imsandli/esp32-access-bridge/hardware/docs/images/pcb-bottom.png

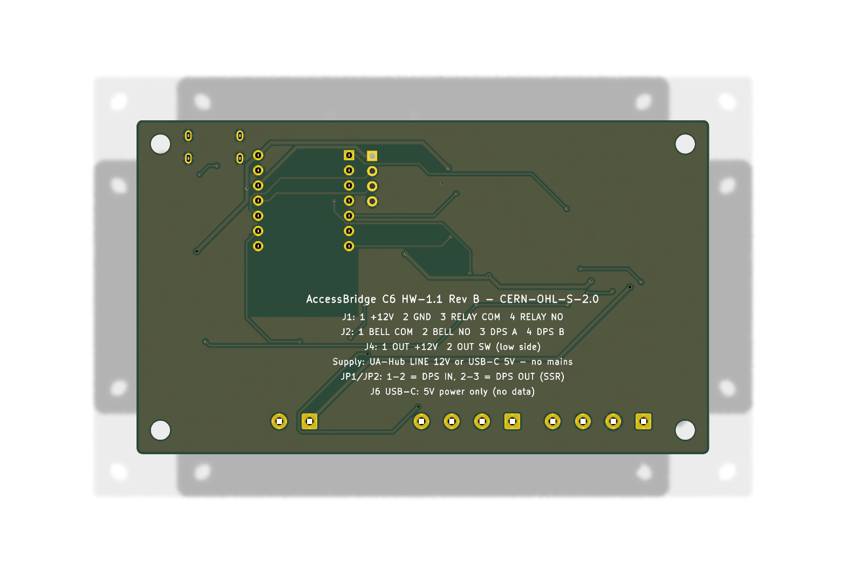
hardware/docs/images/pcb-bottom.png
