imsandli/esp32-access-bridge/hardware/docs/images/pcb-top.png

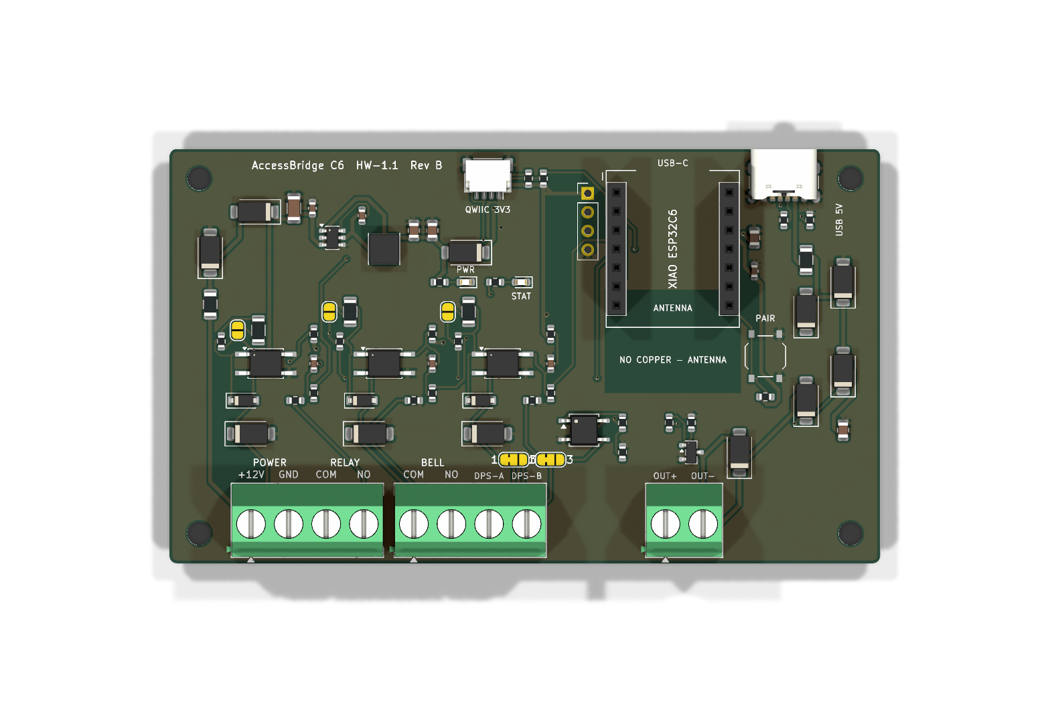
hardware/docs/images/pcb-top.png
