imsandli/esp32-access-bridge/hardware/enclosure/drawings/enclosure-base-din-underside.png

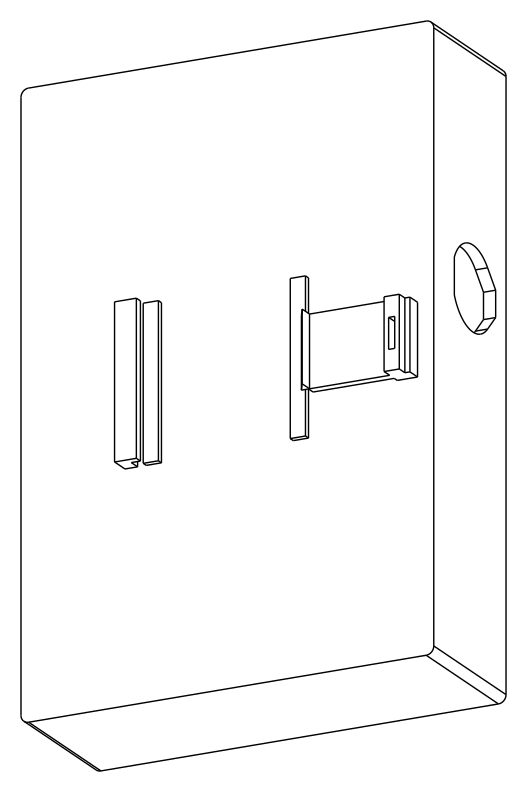
hardware/enclosure/drawings/enclosure-base-din-underside.png
