imsandli/esp32-access-bridge/hardware/enclosure/drawings/enclosure-base-top.png

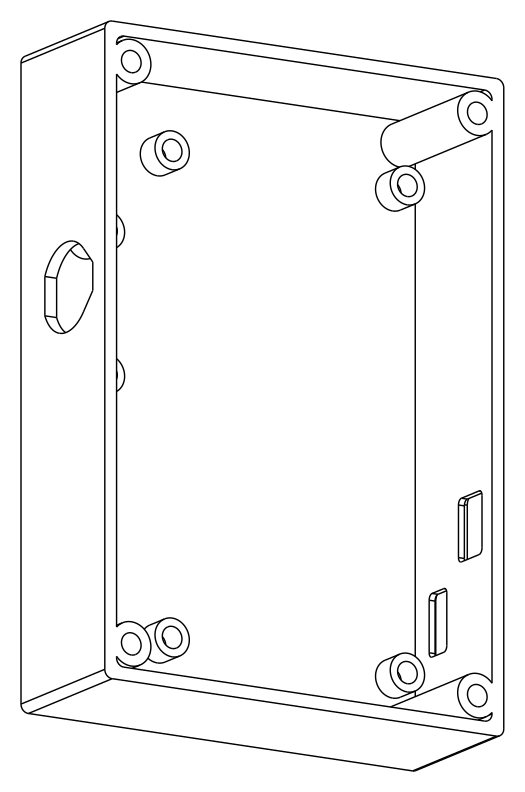
hardware/enclosure/drawings/enclosure-base-top.png
