imsandli/esp32-access-bridge/hardware/enclosure/drawings/enclosure-base-usb-side.png

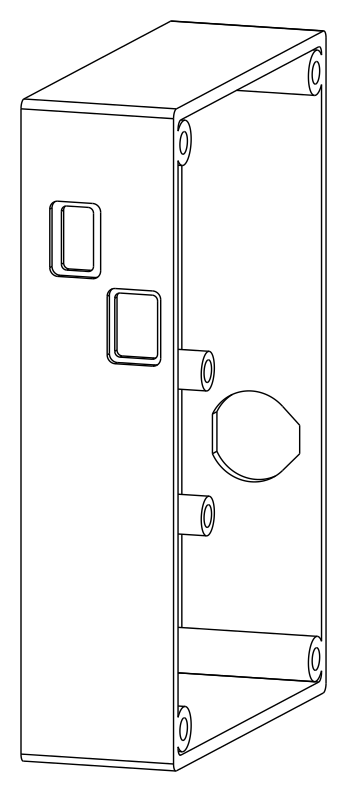
hardware/enclosure/drawings/enclosure-base-usb-side.png
