imsandli/esp32-access-bridge/hardware/enclosure/drawings/enclosure-base-wall-underside.png

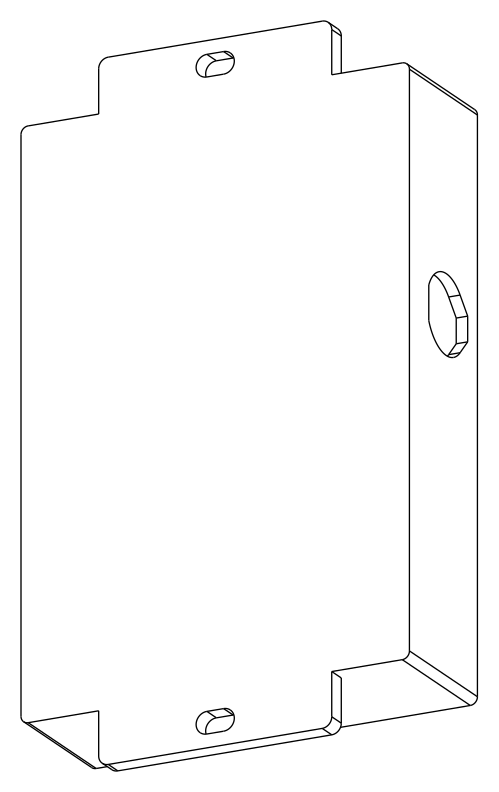
hardware/enclosure/drawings/enclosure-base-wall-underside.png
