imsandli/esp32-access-bridge/hardware/enclosure/drawings/enclosure-base-wall.png

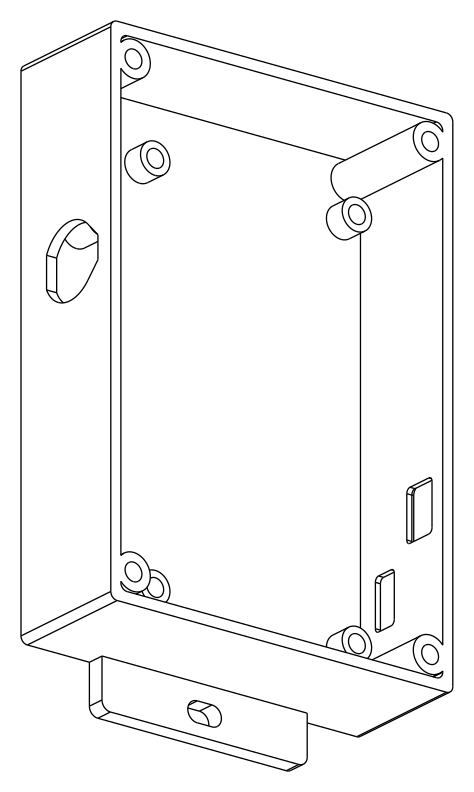
hardware/enclosure/drawings/enclosure-base-wall.png
