imsandli/esp32-access-bridge/hardware/enclosure/drawings/enclosure-lid.png

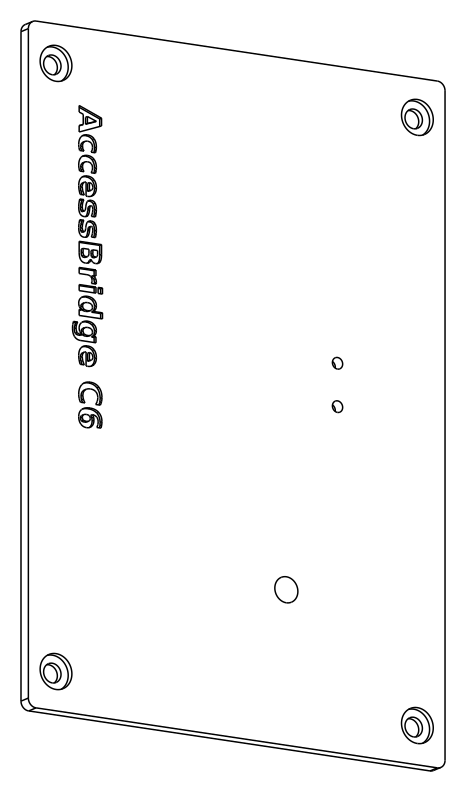
hardware/enclosure/drawings/enclosure-lid.png
