imsandli/esp32-access-bridge/hardware/manufacturing/bom/accessbridge-bom-full.csv

Designator | Value | Footprint | Manufacturer | MPN | LCSC | LCSC status | Qty | DNP
C1 | 10u/50V | Capacitor_SMD:C_1206_3216Metric | Samsung | CL31A106KBHNNNE | C13585 | secondary | 1
C2,C3,C7 | 100n | Capacitor_SMD:C_0603_1608Metric | YAGEO | CC0603KRX7R9BB104 | C14663 | confirmed | 3
C4,C5 | 22u/25V | Capacitor_SMD:C_0805_2012Metric | Samsung | CL21A226MAQNNNE | C45783 | secondary | 2
C6,C11 | 10u/25V | Capacitor_SMD:C_0805_2012Metric | Samsung | CL21A106KAYNNNE | C15850 | secondary | 2
C8,C9,C10 | 10n | Capacitor_SMD:C_0603_1608Metric | FH | 0603B103K500NT | C57112 | confirmed | 3
D1 | SMAJ15A | Diode_SMD:D_SMA | Littelfuse | SMAJ15A | C148216 | confirmed | 1
D2,D3,D12,D13,D15,D16 | SS14 | Diode_SMD:D_SMA | MDD | SS14 | C2480 | confirmed | 6
D4 | yellow-green | LED_SMD:LED_0603_1608Metric | Hubei KENTO | KT-0603YG | C2289 | confirmed | 1
D5 | red | LED_SMD:LED_0603_1608Metric | Hubei KENTO | KT-0603R | C2286 | secondary | 1
D6,D7,D8 | 1N4148W | Diode_SMD:D_SOD-123 | ST(Semtech) | 1N4148W | C81598 | confirmed | 3
D9,D10,D11 | SMAJ15CA | Diode_SMD:D_SMA | MDD | SMAJ15CA | C110044 | confirmed | 3
D14 | SMAJ5.0A | Diode_SMD:D_SMA | Littelfuse | SMAJ5.0A | C83329 | confirmed | 1
F1 | 200mA/30V | Fuse:Fuse_1206_3216Metric | BHFUSE | BSMD1206-020-30V | C883118 | confirmed | 1
F2 | 500mA/30V | Fuse:Fuse_1206_3216Metric | BHFUSE | BSMD1206-050-30V | C883126 | confirmed | 1
J1 | PWR+RELAY | TerminalBlock_Phoenix:TerminalBlock_Phoenix_MKDS-1,5-4-5.08_1x04_P5.08mm_Horizontal | Phoenix Contact | MKDS 1,5/ 4-5,08 (1715747) or 5.08 mm equivalent |  | manual | 1
J2 | BELL+DPS | TerminalBlock_Phoenix:TerminalBlock_Phoenix_MKDS-1,5-4-5.08_1x04_P5.08mm_Horizontal | Phoenix Contact | MKDS 1,5/ 4-5,08 (1715747) or 5.08 mm equivalent |  | manual | 1
J3 | Qwiic | Connector_JST:JST_SH_SM04B-SRSS-TB_1x04-1MP_P1.00mm_Horizontal | JST | SM04B-SRSS-TB(LF)(SN) | C160404 | confirmed | 1
J4 | OUT | TerminalBlock_Phoenix:TerminalBlock_Phoenix_MKDS-1,5-2-5.08_1x02_P5.08mm_Horizontal | Phoenix Contact | MKDS 1,5/ 2-5,08 (1715721) or 5.08 mm equivalent |  | manual | 1
J5 | EXP | Connector_PinHeader_2.54mm:PinHeader_1x04_P2.54mm_Vertical | generic | 2.54 mm 1x4 pin header |  | manual | 1 | DNP
J6 | USB-C 5V | Connector_USB:USB_C_Receptacle_GCT_USB4125-xx-x_6P_TopMnt_Horizontal | GCT | USB4125-GF-A | C3151650 | confirmed | 1
L1 | 4.7u | Inductor_SMD:L_Changjiang_FNR4030S | Sunlord | SWPA4030S4R7MT | C57269 | confirmed | 1
Q1 | AO3400A | Package_TO_SOT_SMD:SOT-23 | AOS | AO3400A | C20917 | confirmed | 1
R1,R2,R11,R13,R15,R17,R19,R21 | 1k | Resistor_SMD:R_0603_1608Metric | UNI-ROYAL | 0603WAF1001T5E | C21190 | confirmed | 8
R3,R7,R9,R12,R16,R20 | 10k | Resistor_SMD:R_0603_1608Metric | UNI-ROYAL | 0603WAF1002T5E | C25804 | confirmed | 6
R4,R5 | 4.7k | Resistor_SMD:R_0603_1608Metric | UNI-ROYAL | 0603WAF4701T5E | C23162 | confirmed | 2
R6 | 100 | Resistor_SMD:R_0603_1608Metric | UNI-ROYAL | 0603WAF1000T5E | C22775 | secondary | 1
R8 | 470 | Resistor_SMD:R_0603_1608Metric | UNI-ROYAL | 0603WAF4700T5E | C23179 | confirmed | 1
R10,R14,R18 | 2.2k | Resistor_SMD:R_0603_1608Metric | UNI-ROYAL | 0603WAF2201T5E | C4190 | secondary | 3
R22,R23 | 5.1k | Resistor_SMD:R_0603_1608Metric | UNI-ROYAL | 0603WAF5101T5E | C23186 | confirmed | 2
R24,R25,R26 | 1k | Resistor_SMD:R_1206_3216Metric | UNI-ROYAL | 1206W4F1001T5E | C4410 | confirmed | 3
SW1 | PAIR | Button_Switch_SMD:SW_Push_1P1T_XKB_TS-1187A | XKB | TS-1187A-B-A-B | C318884 | confirmed | 1
U1 | AP63205WU-7 | Package_TO_SOT_SMD:TSOT-23-6 | Diodes Inc. | AP63205WU-7 | C2071056 | confirmed | 1
U2 | XIAO_ESP32C6 | AccessBridge:XIAO_ESP32C6_Socketed | Seeed Studio | 113991254 (module) + 2x female header 1x7 2.54 mm |  | manual | 1
U3,U4,U5 | EL357C | Package_SO:SO-4_4.4x3.6mm_P2.54mm | UMW | EL357C | C725794 | confirmed | 3
U6 | CPC1014NTR | Package_SO:SOP-4_3.8x4.1mm_P2.54mm | Littelfuse/IXYS | CPC1014NTR | C2760365 | confirmed | 1
