imsandli/esp32-access-bridge/hardware/enclosure/models/accessbridge-enclosure-base-wall.step

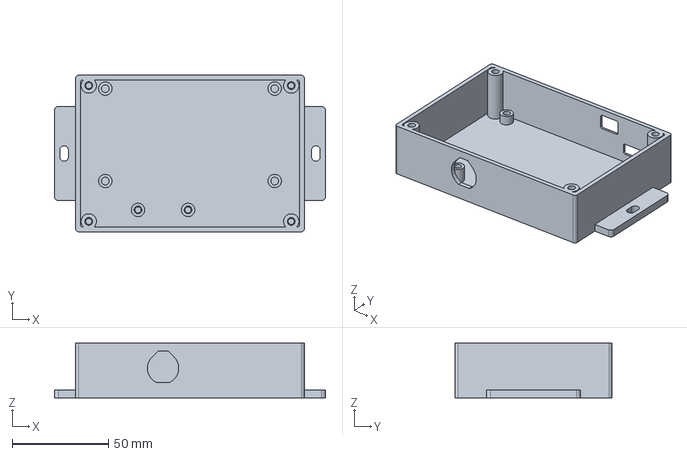
[picture p11: CAD file, 2026-10-18]
hardware/enclosure/models/accessbridge-enclosure-base-wall.step
140.8 x 81.4 x 28.5 mm
