imsandli/esp32-access-bridge/hardware/enclosure/models/pcb/accessbridge-c6.step

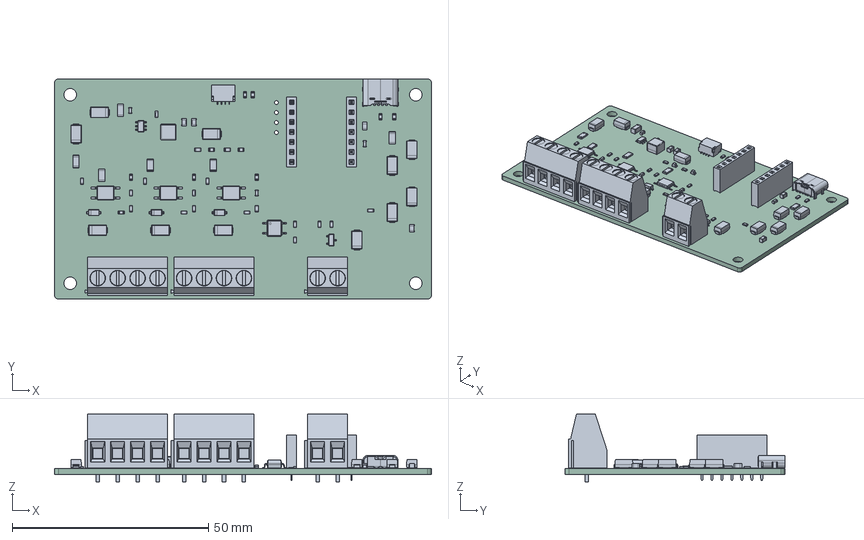
[picture p12: CAD file, 2026-10-18]
hardware/enclosure/models/pcb/accessbridge-c6.step
96.0 x 56.0 x 17.3 mm
Fuse_1206_3216Metric x 2
SO-4_4.4x3.6mm_P2.54mm x 3
R_0603_1608Metric x 23
LED_0603_1608Metric x 2
TerminalBlock_Phoenix_MKDS-1,5-4-5.08_1x04_P5.08mm_Horizontal x 2
D_SMA x 11
C_0805_2012Metric x 4
TerminalBlock_Phoenix_MKDS-1,5-2-5.08_1x02_P5.08mm_Horizontal
D_SOD-123 x 3
R_1206_3216Metric x 3
C_0603_1608Metric x 6
JST_SH_SM04B-SRSS-TB_1x04-1MP_P1.00mm_Horizontal
PinSocket_1x07_P2.54mm_Vertical x 2
USB_C_Receptacle_GCT_USB4125-xx-x_6P_TopMnt_Horizontal
C_1206_3216Metric
TSOT-23-6
SOT-23
L_Changjiang_FNR4030S
SOP-4_3.8x4.1mm_P2.54mm
accessbridge_PCB
