imsandli/esp32-access-bridge/hardware/enclosure/models/accessbridge-enclosure-base-din.step

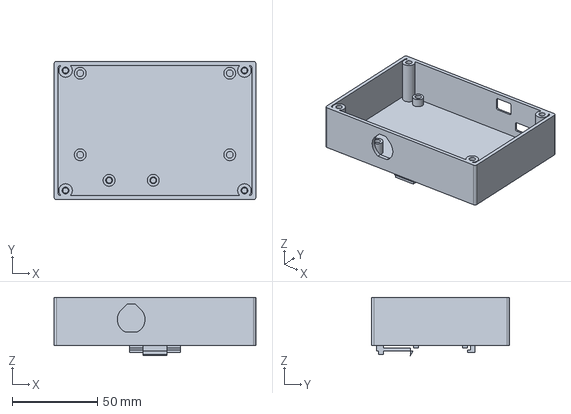
[picture p13: CAD file, 2026-10-18]
hardware/enclosure/models/accessbridge-enclosure-base-din.step
118.8 x 81.4 x 34.4 mm
