imsandli/esp32-access-bridge/hardware/enclosure/models/accessbridge-enclosure-plunger.step

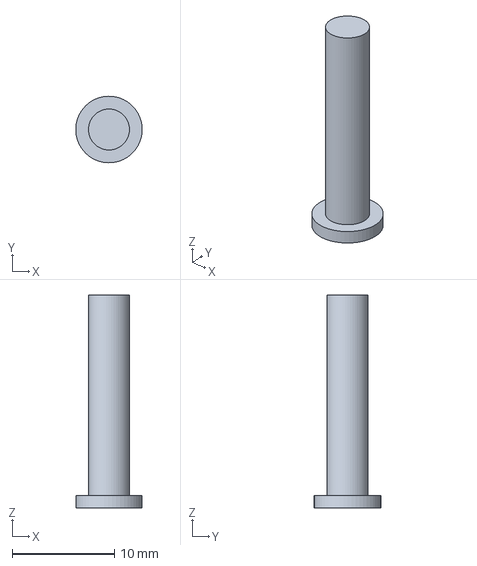
[picture p14: CAD file, 2026-10-18]
hardware/enclosure/models/accessbridge-enclosure-plunger.step
6.49 x 6.50 x 20.8 mm
