imsandli/esp32-access-bridge/hardware/enclosure/models/accessbridge-enclosure-lid.step

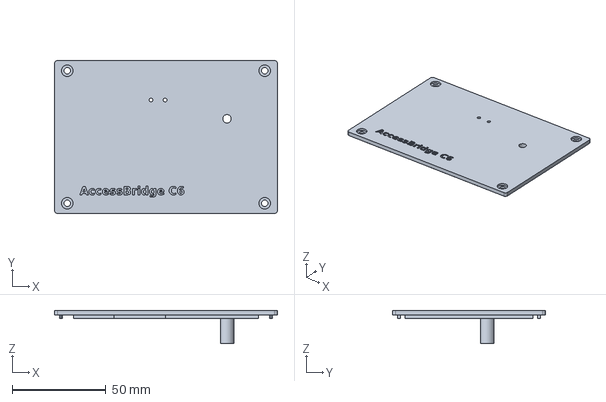
[picture p15: CAD file, 2026-10-18]
hardware/enclosure/models/accessbridge-enclosure-lid.step
118.8 x 81.4 x 17.8 mm
