imsandli/esp32-access-bridge/hardware/enclosure/models/accessbridge-enclosure-clamp.step

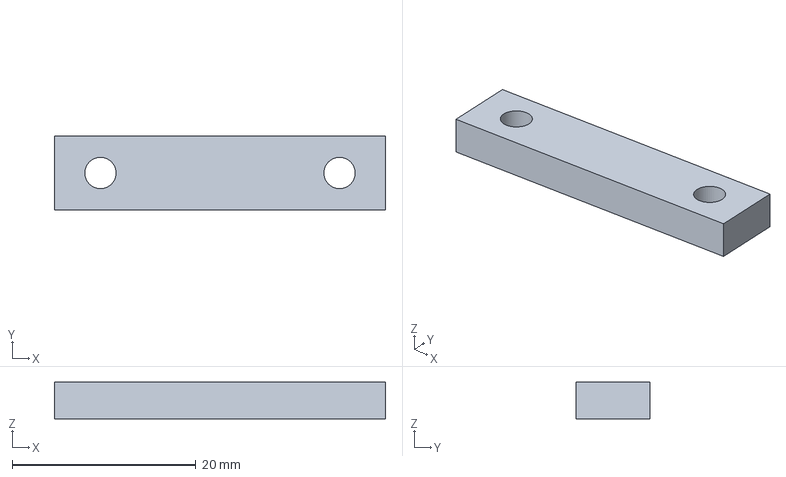
[picture p16: CAD file, 2026-10-18]
hardware/enclosure/models/accessbridge-enclosure-clamp.step
36.0 x 8.00 x 4.00 mm
