imsandli/esp32-access-bridge/(list of files, cad)

Other CAD files:
hardware/enclosure/models/accessbridge-enclosure-base-din.stl
hardware/enclosure/models/accessbridge-enclosure-base-wall.stl
hardware/enclosure/models/accessbridge-enclosure-clamp.stl
hardware/enclosure/models/accessbridge-enclosure-lid.stl
hardware/enclosure/models/accessbridge-enclosure-plunger.stl
