imsandli/esp32-access-bridge/hardware/docs/schematic.pdf

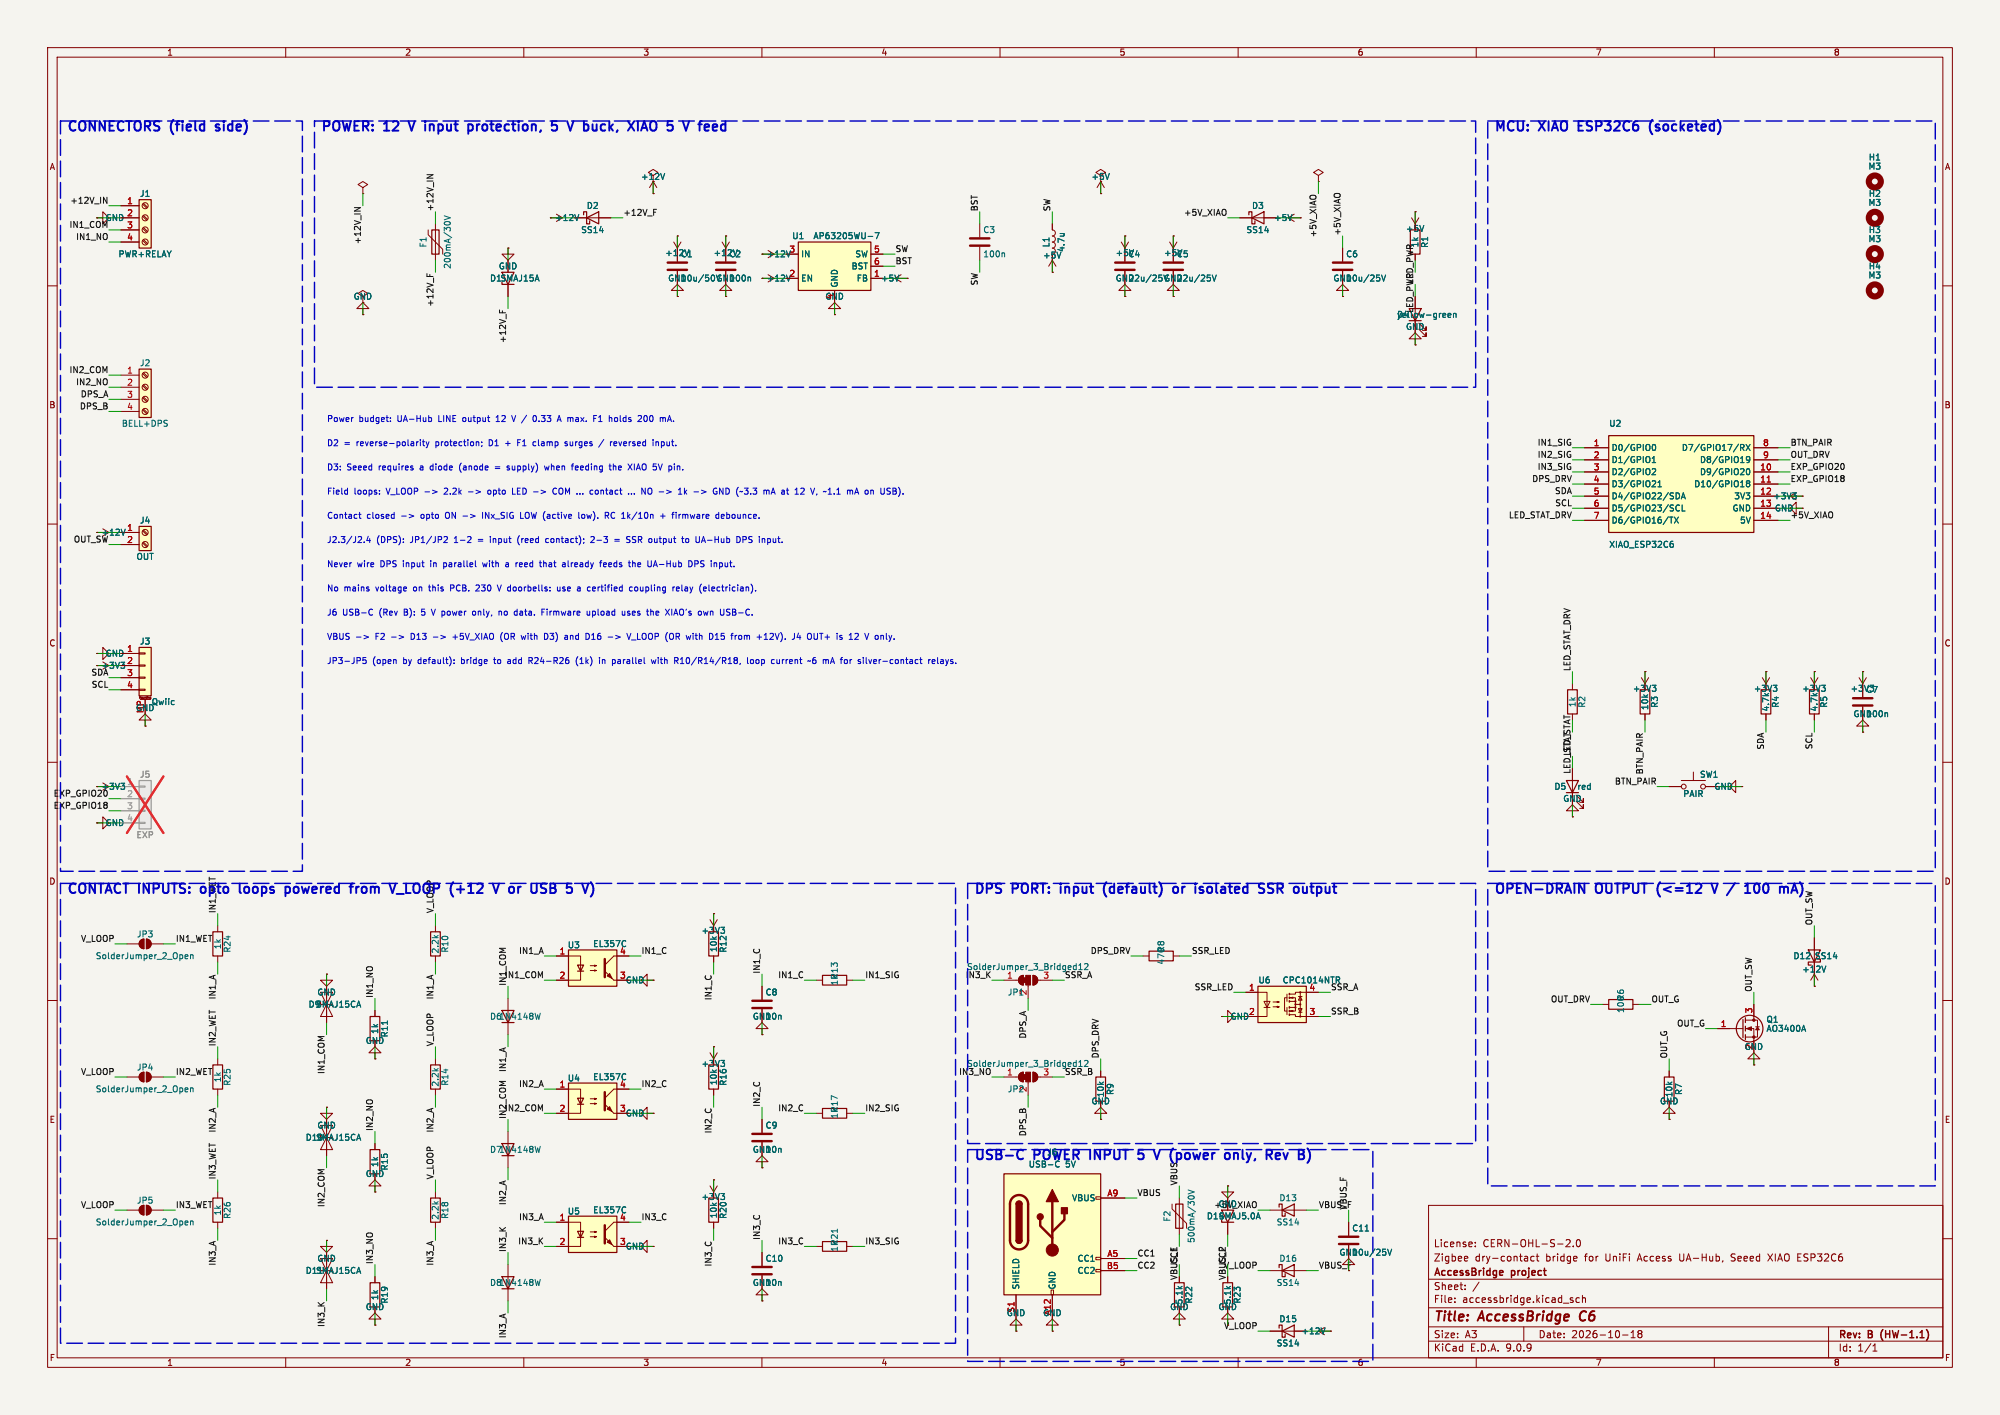
[picture p17: page 1]

4 SW 5 BST 6 FB 1 U1 AP63205WU-7 GND
