imsandli/esp32-access-bridge/hardware/docs/assembly-top.pdf

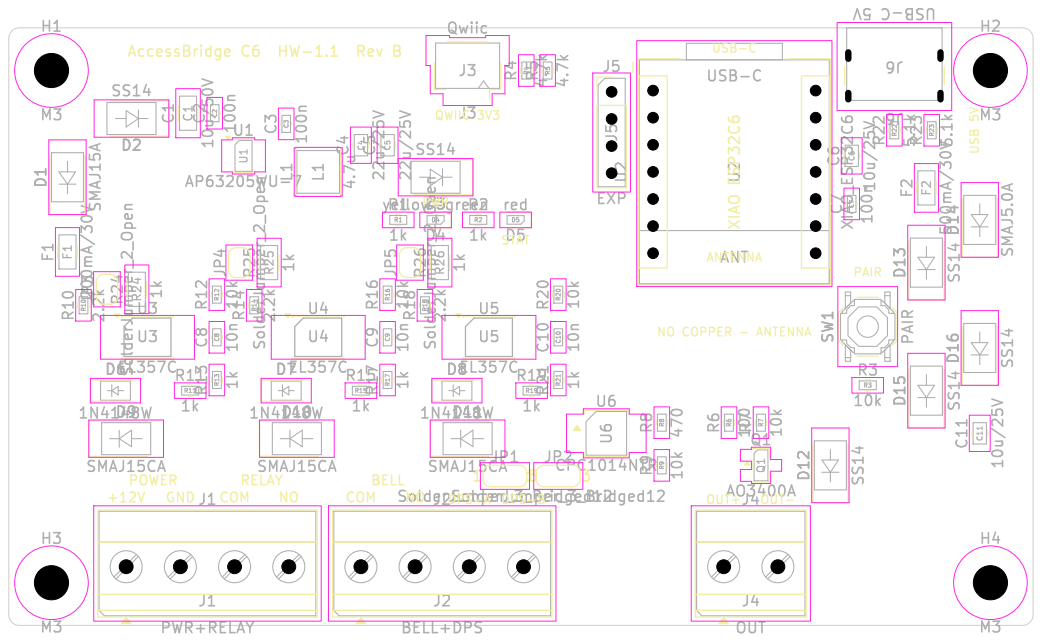
[picture p18: page 1]
