imsandli/esp32-access-bridge/hardware/enclosure/drawings/accessbridge-c6-dimensions.pdf

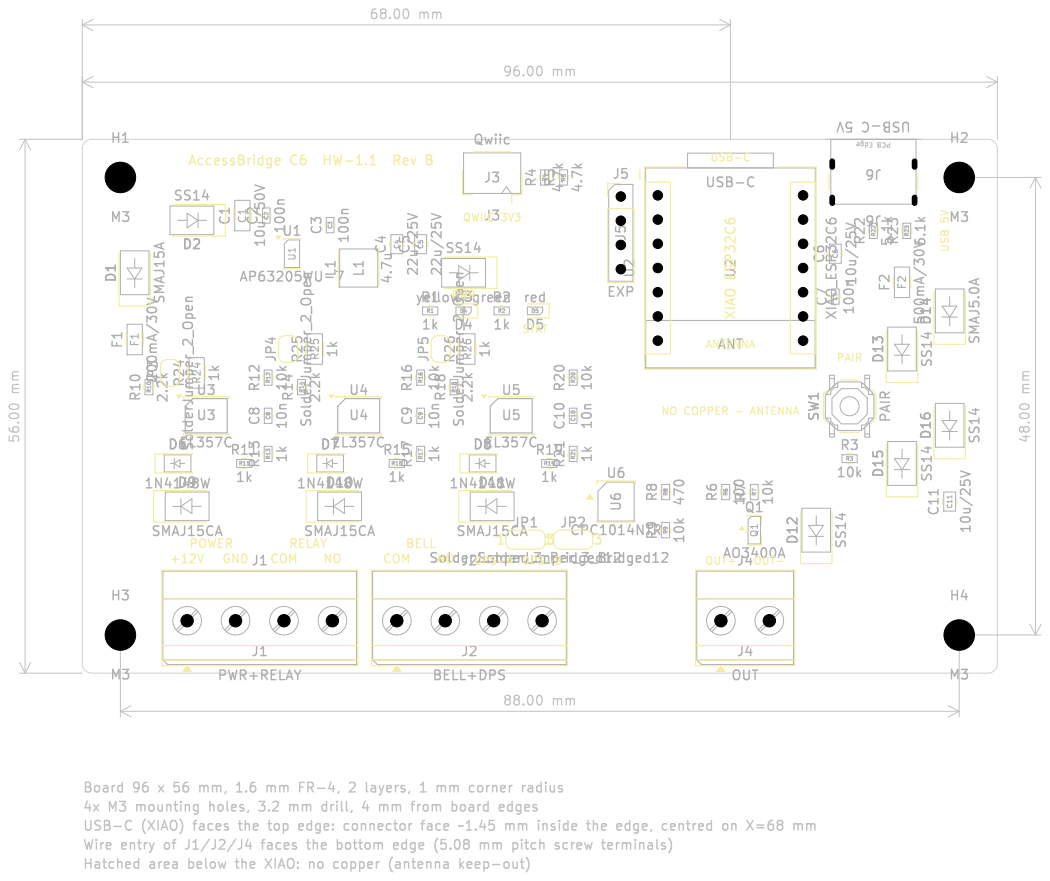
[picture p19: page 1]
