imsandli/esp32-access-bridge/hardware/kicad/accessbridge.kicad_pcb

## KiCad design hardware/kicad/accessbridge.kicad_pcb (2026-10-18)

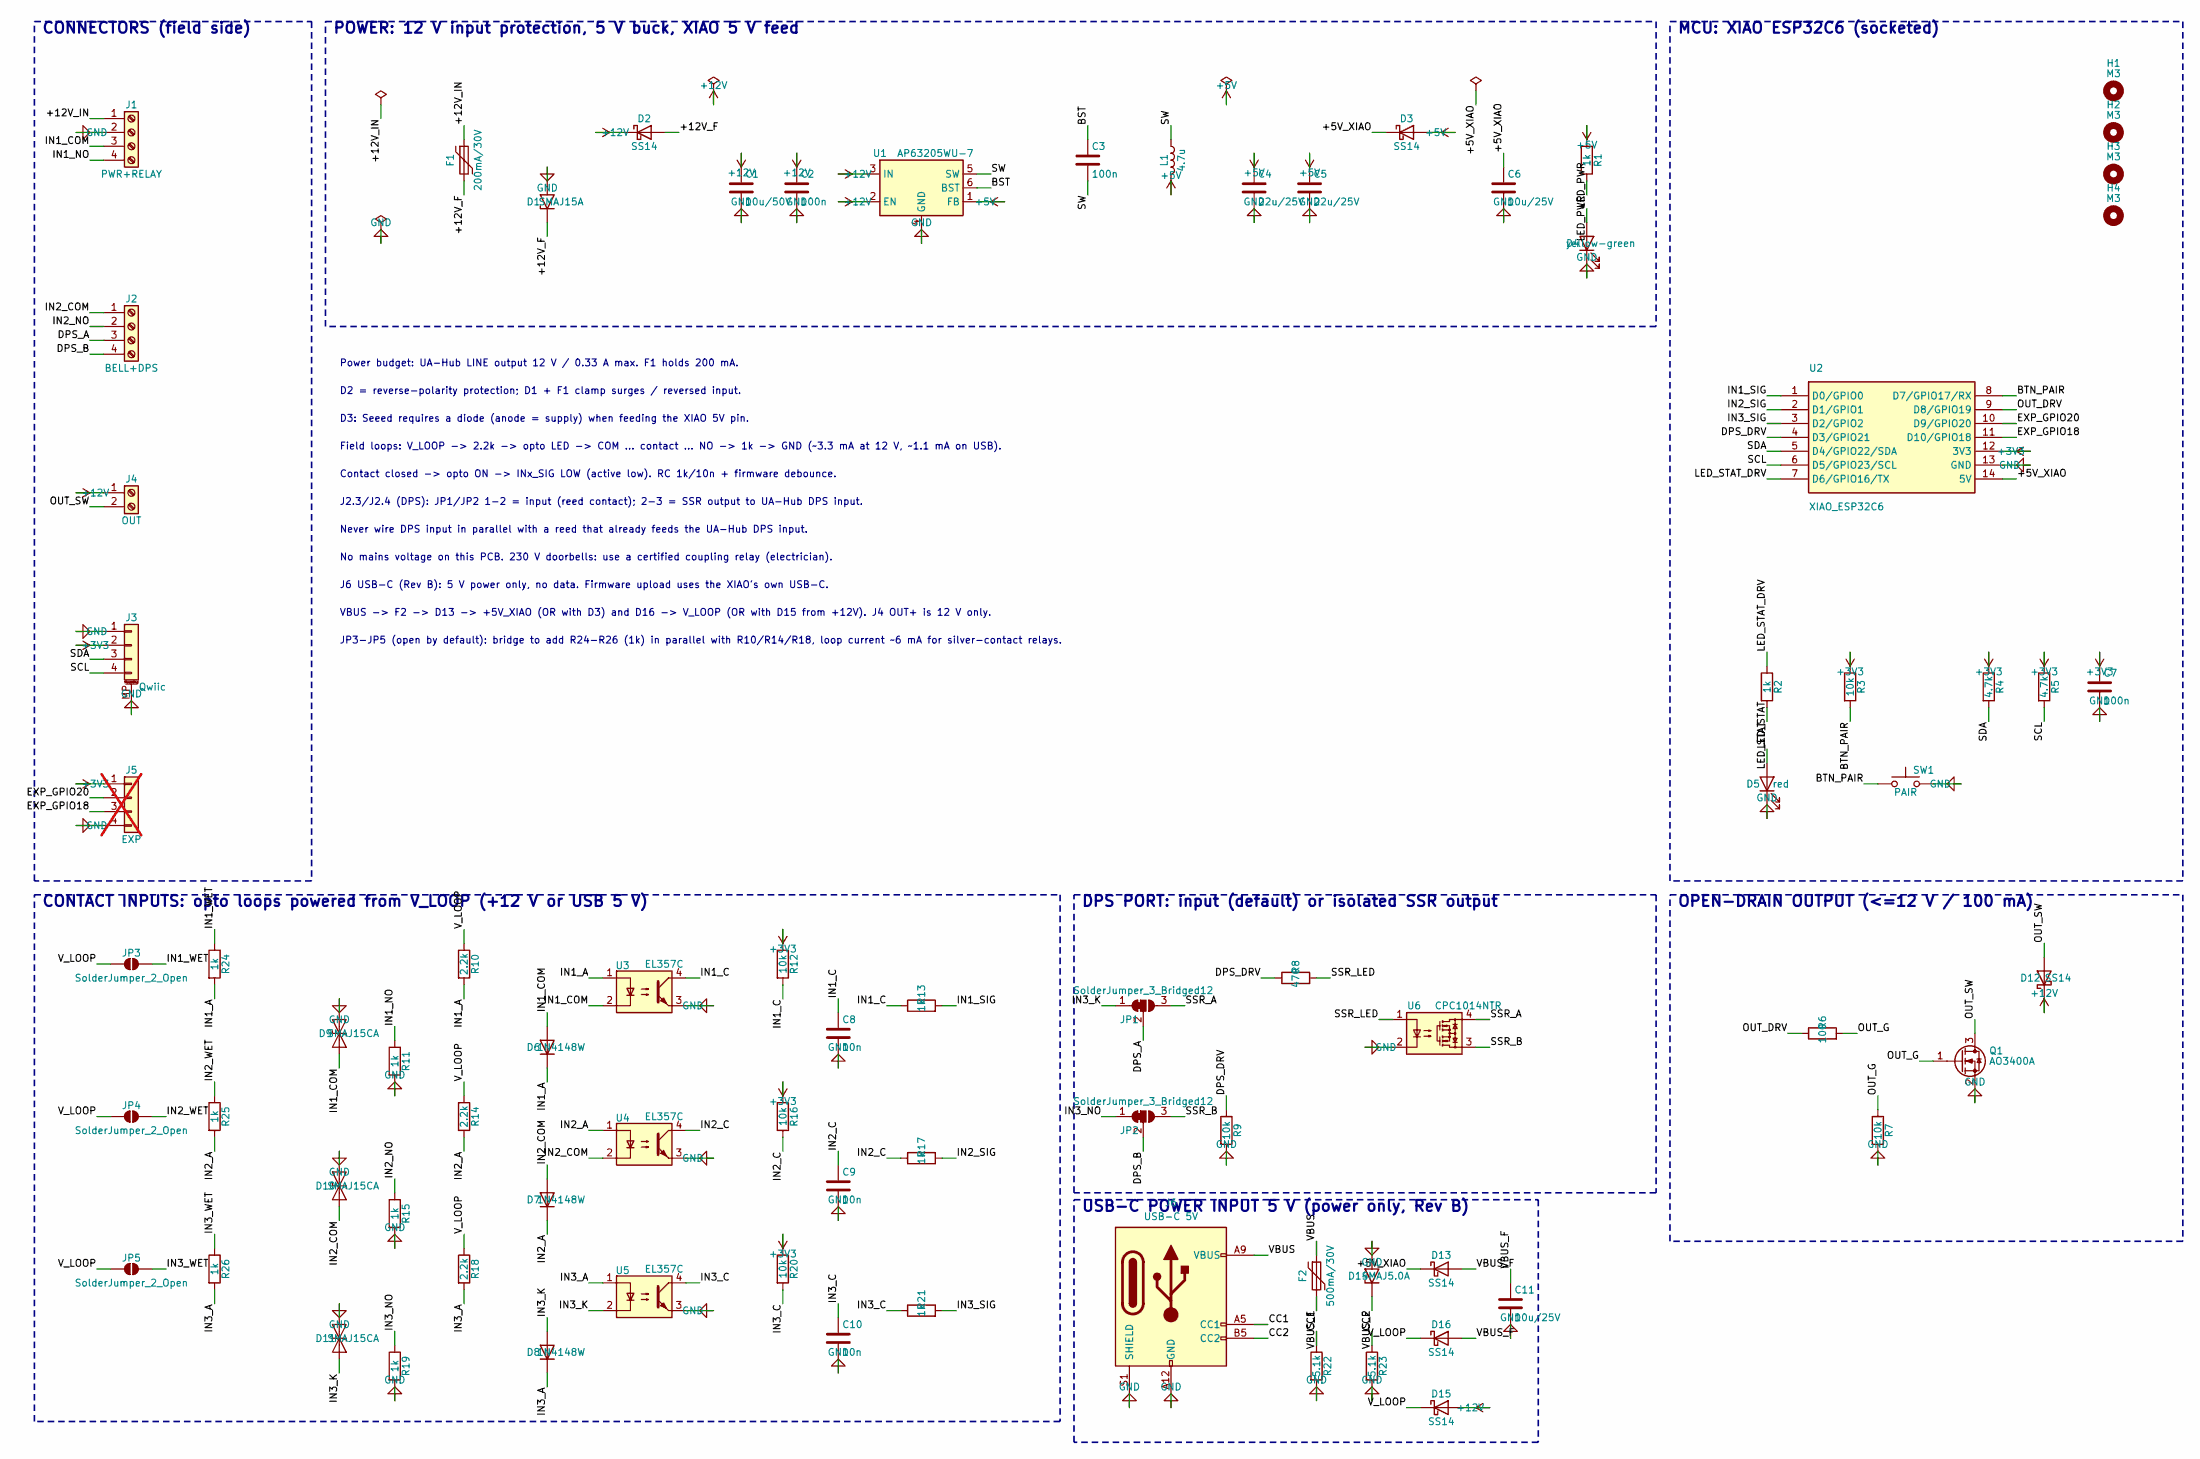
[picture p20: schematic accessbridge.kicad_sch, AccessBridge C6]

Parts:
C1: 10u/50V; C_1206_3216Metric; MPN CL31A106KBHNNNE; LCSC C13585
C2, C3, C7: 100n; C_0603_1608Metric; MPN CC0603KRX7R9BB104; LCSC C14663
C4, C5: 22u/25V; C_0805_2012Metric; MPN CL21A226MAQNNNE; LCSC C45783
C6, C11: 10u/25V; C_0805_2012Metric; MPN CL21A106KAYNNNE; LCSC C15850
C8, C9, C10: 10n; C_0603_1608Metric; MPN 0603B103K500NT; LCSC C57112
D1: SMAJ15A; D_SMA; MPN SMAJ15A; LCSC C148216
D2, D3, D12, D13, D15, D16: SS14; D_SMA; MPN SS14; LCSC C2480
D4: yellow-green; LED_0603_1608Metric; MPN KT-0603YG; LCSC C2289
D5: red; LED_0603_1608Metric; MPN KT-0603R; LCSC C2286
D6, D7, D8: 1N4148W; D_SOD-123; MPN 1N4148W; LCSC C81598
D9, D10, D11: SMAJ15CA; D_SMA; MPN SMAJ15CA; LCSC C110044
D14: SMAJ5.0A; D_SMA; MPN SMAJ5.0A; LCSC C83329
F1: 200mA/30V; Fuse_1206_3216Metric; MPN BSMD1206-020-30V; LCSC C883118
F2: 500mA/30V; Fuse_1206_3216Metric; MPN BSMD1206-050-30V; LCSC C883126
H1, H2, H3, H4: M3; MountingHole_3.2mm_M3; MPN M3 mounting hole; LCSC_Status pcb
J1: PWR+RELAY; TerminalBlock_Phoenix_MKDS-1,5-4-5.08_1x04_P5.08mm_Horizont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; MPN MKDS 1,5/ 4-5,08 (1715747) or 5.08 mm e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; LCSC_Status manual
J2: BELL+DPS; TerminalBlock_Phoenix_MKDS-1,5-4-5.08_1x04_P5.08mm_Horizont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; MPN MKDS 1,5/ 4-5,08 (1715747) or 5.08 mm e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; LCSC_Status manual
J3: Qwiic; JST_SH_SM04B-SRSS-TB_1x04-1MP_P1.00mm_Horizontal; MPN SM04B-SRSS-TB(LF)(SN); LCSC C160404
J4: OUT; TerminalBlock_Phoenix_MKDS-1,5-2-5.08_1x02_P5.08mm_Horizont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; MPN MKDS 1,5/ 2-5,08 (1715721) or 5.08 mm e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; LCSC_Status manual
J5: EXP; PinHeader_1x04_P2.54mm_Vertical; MPN 2.54 mm 1x4 pin header; LCSC_Status manual; not fitted
J6: USB-C 5V; USB_C_Receptacle_GCT_USB4125-xx-x_6P_TopMnt_Horizontal; MPN USB4125-GF-A; LCSC C3151650
JP1, JP2: SolderJumper_3_Bridged12; SolderJumper-3_P1.3mm_Bridged12_RoundedPad1.0x1.5mm_NumberL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; MPN PCB solder jumper; LCSC_Status pcb
JP3, JP4, JP5: SolderJumper_2_Open; SolderJumper-2_P1.3mm_Open_RoundedPad1.0x1.5mm; MPN PCB solder jumper; LCSC_Status pcb
L1: 4.7u; L_Changjiang_FNR4030S; MPN SWPA4030S4R7MT; LCSC C57269
Q1: AO3400A; SOT-23; MPN AO3400A; LCSC C20917
R1, R2, R11, R13, R15, R17, R19, R21: 1k; R_0603_1608Metric; MPN 0603WAF1001T5E; LCSC C21190
R3, R7, R9, R12, R16, R20: 10k; R_0603_1608Metric; MPN 0603WAF1002T5E; LCSC C25804
R4, R5: 4.7k; R_0603_1608Metric; MPN 0603WAF4701T5E; LCSC C23162
R6: 100; R_0603_1608Metric; MPN 0603WAF1000T5E; LCSC C22775
R8: 470; R_0603_1608Metric; MPN 0603WAF4700T5E; LCSC C23179
R10, R14, R18: 2.2k; R_0603_1608Metric; MPN 0603WAF2201T5E; LCSC C4190
R22, R23: 5.1k; R_0603_1608Metric; MPN 0603WAF5101T5E; LCSC C23186
R24, R25, R26: 1k; R_1206_3216Metric; MPN 1206W4F1001T5E; LCSC C4410
SW1: PAIR; SW_Push_1P1T_XKB_TS-1187A; MPN TS-1187A-B-A-B; LCSC C318884
U1: AP63205WU-7; TSOT-23-6; MPN AP63205WU-7; LCSC C2071056
U2: XIAO_ESP32C6; XIAO_ESP32C6_Socketed; MPN 113991254 (module) + 2x female header 1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; LCSC_Status manual
U3, U4, U5: EL357C; SO-4_4.4x3.6mm_P2.54mm; MPN EL357C; LCSC C725794
U6: CPC1014NTR; SOP-4_3.8x4.1mm_P2.54mm; MPN CPC1014NTR; LCSC C2760365

Connections:
+3V3: C7.1, J3.2, J5.1, R3.1, R4.1, R5.1, R12.1, R16.1, R20.1, U2.12 (3V3)
+5V: C4.1, C5.1, D3.2 (A), L1.2, R1.1, U1.1 (FB)
+12V: C1.1, C2.1, D2.1 (K), D12.1 (K), D15.2 (A), J4.1, U1.2 (EN), U1.3 (IN)
/+5V_XIAO: C6.1, D3.1 (K), D13.1 (K), U2.14 (5V)
/+12V_F: D1.1 (A1), D2.2 (A), F1.2
/+12V_IN: F1.1, J1.1
/BST: C3.1, U1.6 (BST)
/BTN_PAIR: R3.2, SW1.1, U2.8 (D7/GPIO17/RX)
/CC1: J6.A5 (CC1), R22.1
/CC2: J6.B5 (CC2), R23.1
/DPS_A: J2.3, JP1.2 (C)
/DPS_B: J2.4, JP2.2 (C)
/DPS_DRV: R8.1, R9.1, U2.4 (D3/GPIO21)
/EXP_GPIO18: J5.3, U2.11 (D10/GPIO18)
/EXP_GPIO20: J5.2, U2.10 (D9/GPIO20)
/IN1_A: D6.1 (K), R10.2, R24.2, U3.1
/IN1_C: C8.1, R12.2, R13.1, U3.4
/IN1_COM: D6.2 (A), D9.1 (A1), J1.3, U3.2
/IN1_NO: J1.4, R11.1
/IN1_SIG: R13.2, U2.1 (D0/GPIO0)
/IN1_WET: JP3.2 (B), R24.1
/IN2_A: D7.1 (K), R14.2, R25.2, U4.1
/IN2_C: C9.1, R16.2, R17.1, U4.4
/IN2_COM: D7.2 (A), D10.1 (A1), J2.1, U4.2
/IN2_NO: J2.2, R15.1
/IN2_SIG: R17.2, U2.2 (D1/GPIO1)
/IN2_WET: JP4.2 (B), R25.1
/IN3_A: D8.1 (K), R18.2, R26.2, U5.1
/IN3_C: C10.1, R20.2, R21.1, U5.4
/IN3_K: D8.2 (A), D11.1 (A1), JP1.1 (A), U5.2
/IN3_NO: JP2.1 (A), R19.1
/IN3_SIG: R21.2, U2.3 (D2/GPIO2)
/IN3_WET: JP5.2 (B), R26.1
/LED_PWR: D4.2 (A), R1.2
/LED_STAT: D5.2 (A), R2.2
/LED_STAT_DRV: R2.1, U2.7 (D6/GPIO16/TX)
/OUT_DRV: R6.1, U2.9 (D8/GPIO19)
/OUT_G: Q1.1 (G), R6.2, R7.1
/OUT_SW: D12.2 (A), J4.2, Q1.3 (D)
/SCL: J3.4, R5.2, U2.6 (D5/GPIO23/SCL)
/SDA: J3.3, R4.2, U2.5 (D4/GPIO22/SDA)
/SSR_A: JP1.3 (B), U6.4
/SSR_B: JP2.3 (B), U6.3
/SSR_LED: R8.2, U6.1
/SW: C3.2, L1.1, U1.5 (SW)
/VBUS: F2.1, J6.A9 (VBUS), J6.B9 (VBUS)
/VBUS_F: C11.1, D13.2 (A), D14.1 (A1), D16.2 (A), F2.2
/V_LOOP: D15.1 (K), D16.1 (K), JP3.1 (A), JP4.1 (A), JP5.1 (A), R10.1, R14.1, R18.1
GND: C1.2, C2.2, C4.2, C5.2, C6.2, C7.2, C8.2, C9.2, C10.2, C11.2, D1.2 (A2), D4.1 (K), D5.1 (K), D9.2 (A2), D10.2 (A2), D11.2 (A2), D14.2 (A2), J1.2, J3.1, J3.MP (MountPin), J5.4, J6.A12 (GND), J6.B12 (GND), J6.S1 (SHIELD), Q1.2 (S), R7.2, R9.2, R11.2, R15.2, R19.2, R22.2, R23.2, SW1.2, U1.4 (GND), U2.13 (GND), U3.3, U4.3, U5.3, U6.2

Notes on the sheet:
CONNECTORS (field side)
POWER: 12 V input protection, 5 V buck, XIAO 5 V feed
MCU: XIAO ESP32C6 (socketed)
CONTACT INPUTS: opto loops powered from V_LOOP (+12 V or USB 5 V)
DPS PORT: input (default) or isolated SSR output
OPEN-DRAIN OUTPUT (<=12 V / 100 mA)
USB-C POWER INPUT 5 V (power only, Rev B)
Power budget: UA-Hub LINE output 12 V / 0.33 A max. F1 holds 200 mA.
D2 = reverse-polarity protection; D1 + F1 clamp surges / reversed input.
D3: Seeed requires a diode (anode = supply) when feeding the XIAO 5V pin.
Field loops: V_LOOP -> 2.2k -> opto LED -> COM ... contact ... NO -> 1k -> GND (~3.3 mA at 12 V, ~1.1 mA on USB).
Contact closed -> opto ON -> INx_SIG LOW (active low). RC 1k/10n + firmware debounce.
J2.3/J2.4 (DPS): JP1/JP2 1-2 = input (reed contact); 2-3 = SSR output to UA-Hub DPS input.
Never wire DPS input in parallel with a reed that already feeds the UA-Hub DPS input.
No mains voltage on this PCB. 230 V doorbells: use a certified coupling relay (electrician).
J6 USB-C (Rev B): 5 V power only, no data. Firmware upload uses the XIAO's own USB-C.
VBUS -> F2 -> D13 -> +5V_XIAO (OR with D3) and D16 -> V_LOOP (OR with D15 from +12V). J4 OUT+ is 12 V only.
JP3-JP5 (open by default): bridge to add R24-R26 (1k) in parallel with R10/R14/R18, loop current ~6 mA for silver-contact relays.

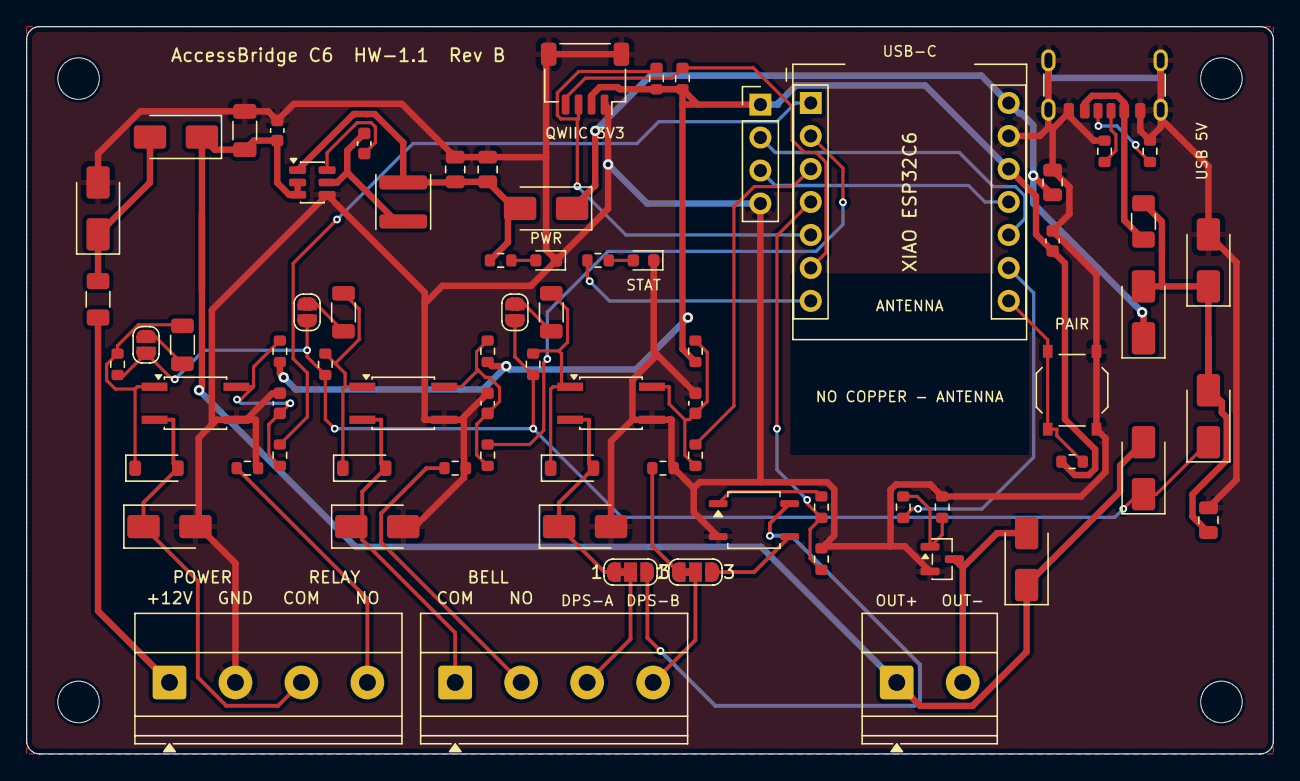
[picture p21: board accessbridge.kicad_pcb from above]

Board: 2 copper layers, 96.0 x 56.0 mm, 79 parts (0 on the bottom side), 49 nets.
