imsandli/esp32-access-bridge/(commit log)

2026-10-18 Add AccessBridge C6 hardware (HW-1.0 Rev A) and ESPHome Zigbee firmware
    KiCad 9 schematic and 2-layer PCB for a Seeed XIAO ESP32C6 carrier powered
    from the UniFi UA-Hub 12 V LINE output: AP63205 buck, reverse-polarity and
    surge protection, three optocoupler dry-contact inputs (relay, doorbell,
    DPS), DPS solid-state relay output, open-drain output and Qwiic port.
    ERC and DRC (with schematic parity) are clean. Includes the bootstrap
    generators, reproducible export scripts and generated JLCPCB data.
    ESPHome 2026.9.1 configuration exposing contact states and pulse counters
    over Zigbee as an end device.
    Claude-Session: https://claude.ai/co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
    [accessbridge-B_Cu.gbl, accessbridge-B_Mask.gbs, accessbridge-B_Paste.gbp, accessbridge-B_Silkscreen.gbo, accessbridge-Edge_Cuts.gm1, accessbridge-F_Cu.gtl, accessbridge-F_Mask.gts, accessbridge-F_Paste.gtp]
2026-10-18 Add Home Assistant blueprints, CI workflows and reproducibility check
    Blueprints for Nuki unlatching (counter-step, freshness, cooldown, enable
    and door gates) and doorbell notifications, validated with Home Assistant
    check_config. Workflows for KiCad ERC/DRC and fabrication export, ESPHome
    compile, and tagged releases. Firmware pins stable Zigbee endpoints.
    Claude-Session: https://claude.ai/code/session_017ugbcLJnibWHxuv1cA2VcH
2026-10-18 Add licenses, blueprint behaviour tests and CI result annotations
    MIT for software, CERN-OHL-S-2.0 for hardware. Home Assistant blueprint
    tests run a real HA core with mocked lock/log services and cover new
    pulse, restore, reboot, counter jump, stale pulse, cooldown, enable and
    door gates, unconfirmed unlatch and doorbell rate limiting. Device reboots
    no longer start the unlatch cooldown.
    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
2026-10-18 Add documentation: architecture, security, wiring, testing, manufacturing
    README with compatibility and project status, architecture decisions and
    interface validation, galvanic isolation assessment, trust boundaries and
    failure modes, UA-Hub wiring incl. doorbell coupling relay and DPS port,
    power budget, pinout, assembly/ordering, enclosure fit (Hammond 1591XXD),
    cost estimate, test plan with hardware/restart/failure scenarios, release
    process and issue templates.
    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
2026-10-18 HW-1.1 Rev B: USB-C power input; 3D-printable enclosure (DIN + wall)
    - J6 power-only USB-C (5.1k CC, 500 mA PTC, SMAJ5.0A), diode-OR into the
    XIAO 5V pin and a new V_LOOP rail for the contact loops
    - Board widened to 96 x 56 mm; Rev A placement and routing kept,
    incremental update/lock workflow in gen_pcb.py
    - Regenerated fabrication data (HW-1.1 Rev B ZIP, BOM, CPL, renders, STEP)
    - Parametric CadQuery enclosure: DIN-rail base, wall-screw base, lid,
    PAIR plunger, cable clamp; fit check against the PCB STEP; CI job
    - Docs, tests plan and changelog updated
    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
    [accessbridge-B_Cu.gbl, accessbridge-B_Mask.gbs, accessbridge-B_Paste.gbp, accessbridge-B_Silkscreen.gbo, accessbridge-Edge_Cuts.gm1, accessbridge-F_Cu.gtl, accessbridge-F_Mask.gts, accessbridge-F_Paste.gtp]
2026-10-18 docs: recommend gold-contact coupling relay for the 230 V doorbell
    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
2026-10-18 Doorbell: any-source blueprint, no-neutral wiring options; wetting-current jumpers
    - doorbell-notify blueprint accepts the AccessBridge counter, an event entity
    (e.g. Shelly input) or a binary sensor (e.g. battery Zigbee contact sensor);
    restore/reconnect ignored, optional event-type filter; 3 new tests (15/15)
    - wiring.md: doorbell routes for 230 V bells without neutral at the push
    (coupling relay at the bell + battery Zigbee sensor, or cable to J2);
    Shelly 1L/2L and Eltako ER61-UC limitations documented
    - Rev B (not manufactured): JP3-JP5 + R24-R26 (1k 1206, C4410) select ~3.3 or
    ~6 mA loop current per input; incremental routing, ERC/DRC clean incl. parity
    - Regenerated fabricati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
    [accessbridge-B_Cu.gbl, accessbridge-B_Mask.gbs, accessbridge-B_Paste.gbp, accessbridge-B_Silkscreen.gbo, accessbridge-Edge_Cuts.gm1, accessbridge-F_Cu.gtl, accessbridge-F_Mask.gts, accessbridge-F_Paste.gtp]
2026-10-18 docs: fix doorbell box example, note sensor backup cell
    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
2026-10-18 BOM: R8 470R = UNI-ROYAL 0603WAF4700T5E (C23179)
    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
    [accessbridge-B_Cu.gbl, accessbridge-B_Mask.gbs, accessbridge-B_Paste.gbp, accessbridge-B_Silkscreen.gbo, accessbridge-Edge_Cuts.gm1, accessbridge-F_Cu.gtl, accessbridge-F_Mask.gts, accessbridge-F_Paste.gtp]
2026-10-18 BOM: optocouplers U3-U5 = UMW EL357C (C725794); sync footprint values on update
    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
    [accessbridge-B_Cu.gbl, accessbridge-B_Mask.gbs, accessbridge-B_Paste.gbp, accessbridge-B_Silkscreen.gbo, accessbridge-Edge_Cuts.gm1, accessbridge-F_Cu.gtl, accessbridge-F_Mask.gts, accessbridge-F_Paste.gtp]
2026-10-18 BOM: D4 PWR LED = KT-0603YG yellow-green (C2289), green 0603 out of stock
    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
    [accessbridge-B_Cu.gbl, accessbridge-B_Mask.gbs, accessbridge-B_Paste.gbp, accessbridge-B_Silkscreen.gbo, accessbridge-Edge_Cuts.gm1, accessbridge-F_Cu.gtl, accessbridge-F_Mask.gts, accessbridge-F_Paste.gtp]
2026-10-18 Enclosure: sized for 7.0 mm XIAO sockets (FREI BL 1X07G7 2,54)
    XIAO and its USB-C cut-out 1.5 mm lower, case 1.5 mm flatter; fit check passes.
    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
    [accessbridge-enclosure-base-din.step, accessbridge-enclosure-base-din.stl, accessbridge-enclosure-base-wall.step, accessbridge-enclosure-base-wall.stl, accessbridge-enclosure-lid.step, accessbridge-enclosure-lid.stl, accessbridge-enclosure-plunger.step, accessbridge-enclosure-plunger.stl]
2026-10-18 CPL: JLCPCB rotation corrections for U1, U6 (270) and Q1 (180)
    Checked in the JLCPCB placement preview: their part models were 90/180 deg off
    the KiCad footprints.
    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
    [accessbridge-jlcpcb-cpl.csv]
2026-10-18 Enclosure: room for SW 22 gland lock nut (+1.2 mm); insert/screw specs in BOM
    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
    [accessbridge-enclosure-base-din.step, accessbridge-enclosure-base-din.stl, accessbridge-enclosure-base-wall.step, accessbridge-enclosure-base-wall.stl, accessbridge-enclosure-lid.step, accessbridge-enclosure-lid.stl, accessbridge-enclosure-plunger.step, accessbridge-enclosure-plunger.stl]
2026-10-18 Enclosure: screw-tip relief below lid and clamp inserts; PCB screws M3 x 6
    M3 x 10 lid screws reach 8.8 mm below the lid and would bottom out in the 6 mm
    insert hole; M3 x 8 PCB screws would hit the floor.
    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
    [accessbridge-enclosure-base-din.step, accessbridge-enclosure-base-din.stl, accessbridge-enclosure-base-wall.step, accessbridge-enclosure-base-wall.stl]
